xerootg/CAN-CCD_bus/board/eelib-master/README.md

# EELib #
A library of components for the KiCad EDA tool.

Component List:
* MCP2515 - Microchip CAN Controller with SPI interface
* MCP2551 - Microchip CAN Transceiver
* PIC32MX2XXX - Microchip 32 bit microcontroller

Licensed under [CC BY-SA 3.0](http://creativecommons.org/licenses/by-sa/3.0/)
