xerootg/CAN-CCD_bus/(list of files, drawings)

Other design files:
board/ccd_can_bridge.dsn
