xerootg/CAN-CCD_bus/board/ccd_can_bridge.kicad_pcb

## KiCad design board/ccd_can_bridge.kicad_pcb (2018-04-17)

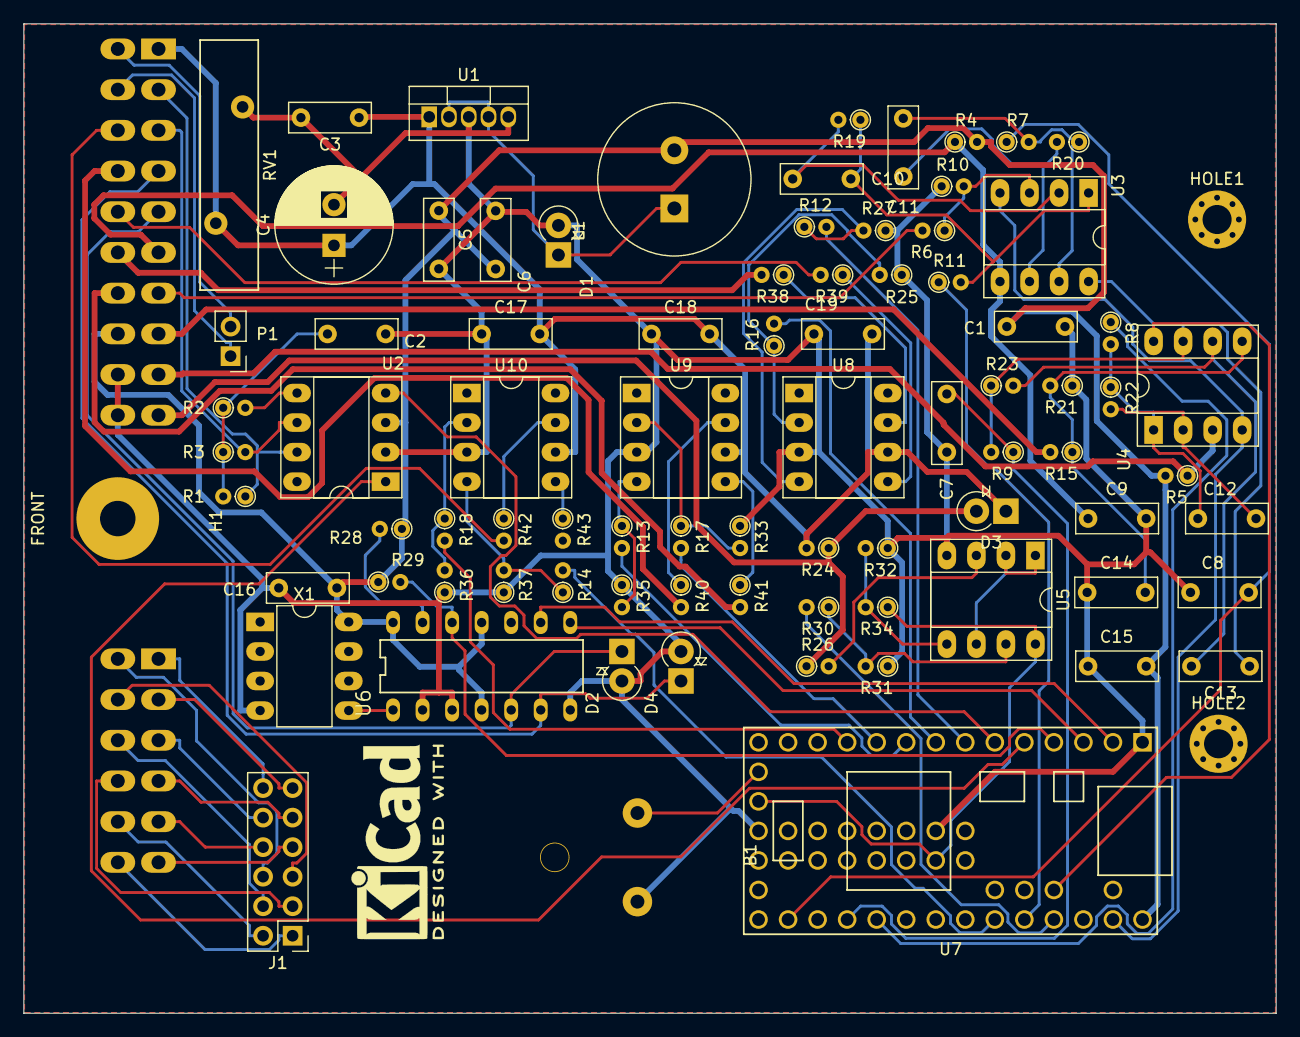
[picture p1: board ccd_can_bridge.kicad_pcb from above]

Board: 2 copper layers, 107.7 x 85.1 mm, 85 parts (0 on the bottom side), 82 nets.

Parts:
B1: 1066; keystone_1067
C1, C3, C6, C17, C18, C19: 0.1uF; C_Disc_D7.0mm_W2.5mm_P5.00mm
C2: 4700pF; C_Disc_D7.0mm_W2.5mm_P5.00mm
C4: 100uF; CP_Radial_D10.0mm_P3.50mm
C5: 100uF; C_Disc_D7.0mm_W2.5mm_P5.00mm
C7, C8, C9, C10, C11, C12, C13, C14: 10uF; C_Disc_D7.0mm_W2.5mm_P5.00mm
C15, C16: C; C_Disc_D7.0mm_W2.5mm_P5.00mm
D1: 1N5819; D_DO-41_SOD81_P2.54mm_Vertical_KathodeUp
D2, D4: 1N4728; D_DO-41_SOD81_P2.54mm_Vertical_KathodeUp
D3: D; D_DO-41_SOD81_P2.54mm_Vertical_KathodeUp
H1: Modice_ME-MX_32; modice_ME-MX-32-position
HOLE1, HOLE2: MountingHole_2.5mm_Pad_Via
J1: CONN_01X12; Pin_Header_Straight_2x06_Pitch2.54mm
L1: 100uH; Inductor_Radial_D13.0mm_P5.00mm
P1: CONN_01X02; Pin_Header_Straight_1x02_Pitch2.54mm
R1, R3: 60; R_Axial_DIN0204_L3.6mm_D1.6mm_P1.90mm_Vertical
R2: 300; R_Axial_DIN0204_L3.6mm_D1.6mm_P1.90mm_Vertical
R4, R5: 130; R_Axial_DIN0204_L3.6mm_D1.6mm_P1.90mm_Vertical
R6, R15: 560; R_Axial_DIN0204_L3.6mm_D1.6mm_P1.90mm_Vertical
R7, R8, R9, R10, R11, R19, R20, R21, R22, R23, R25, R27, R30, R31, R33, R35, R36, R37: 1k; R_Axial_DIN0204_L3.6mm_D1.6mm_P1.90mm_Vertical
R12, R13, R14, R16, R17, R18: 20; R_Axial_DIN0204_L3.6mm_D1.6mm_P1.90mm_Vertical
R24, R26, R28, R29: 10k; R_Axial_DIN0204_L3.6mm_D1.6mm_P1.90mm_Vertical
R32: 37k; R_Axial_DIN0204_L3.6mm_D1.6mm_P1.90mm_Vertical
R34: 15k; R_Axial_DIN0204_L3.6mm_D1.6mm_P1.90mm_Vertical
R38, R39, R40, R41, R42, R43: 100; R_Axial_DIN0204_L3.6mm_D1.6mm_P1.90mm_Vertical
RV1: ERZ-V20D220; RV_Disc_D21.5_W5_P10
U1: LM2576HVS-5.0/NOPB; TO-220-5_Pentawatt_Multiwatt-5_Vertical
U2: MCP2561; DIP-8_W7.62mm_Socket_LongPads
U3, U4, U5: MCP6002; DIP-8_W7.62mm_Socket_LongPads
U6: CDP68HC68S1
U7: Teensy3.2; Teensy30_31_32_LC
U8, U9, U10: TC4427; DIP-8_W7.62mm_Socket_LongPads
X1: OSCILLATOR-VDD-4; DIP-8_W7.62mm_LongPads

Connections:
+3V3: R34.1, U5.8, U7.16, U7.50
+12V: C3.1, C4.1, C17.2, C18.2, C19.2, D3.1, H1.1, R24.2, RV1.1, U1.1, U8.6, U9.6, U10.6
A0_fuel_level: C8.2, R7.1, U7.21
A1_VSS_count: R11.1, U7.29
A2_oil_pressure: C7.2, R9.1, U7.23
A3_steering_wheel: R8.1, U7.24
Earth: B1.-, C1.1, C2.1, C3.2, C4.2, C5.2, C6.2, C7.1, C8.1, C9.1, C14.1, C15.2, C16.2, C17.1, C18.1, C19.1, D1.2, D2.2, D4.2, H1.19, H1.20, R10.1, R21.1, R25.1, R27.1, R31.1, R32.1, R33.1, R35.1, R36.1, R37.1, RV1.2, U1.3, U1.5, U2.2, U5.4, U6.2, U6.3, U6.7, U7.1, U7.17, U7.39, U8.3, U9.3, U10.3, X1.4
unnamed: B1.+, U7.15
unnamed: C2.2, R1.2, R2.1, R3.1
unnamed: C10.1, R11.2, R19.1, U3.1
unnamed: C10.2, R19.2, U3.2
unnamed: C11.1, R7.2, R20.1, U3.7
unnamed: C11.2, R20.2, U3.6
unnamed: C12.1, R8.2, R22.1, U4.1
unnamed: C12.2, R22.2, U4.2
unnamed: C13.1, R9.2, R23.1, U4.7
unnamed: C13.2, R23.2, U4.6
unnamed: C14.2, R15.1, R21.2, U4.5
unnamed: D1.1, L1.1, U1.2, U1.4
unnamed: H1.11, P1.2
unnamed: H1.12, P1.1
unnamed: H1.21, J1.12
unnamed: H1.22, J1.11
unnamed: H1.23, J1.10
unnamed: H1.24, J1.9
unnamed: H1.25, J1.8
unnamed: H1.26, J1.7
unnamed: H1.27, J1.6
unnamed: H1.28, J1.5
unnamed: H1.29, J1.4
unnamed: H1.30, J1.3
unnamed: H1.31, J1.2
unnamed: H1.32, J1.1
unnamed: R2.2, U2.5
unnamed: R6.1, R10.2, U3.3
unnamed: R12.1, R27.2, U8.4
unnamed: R13.1, R35.2, U9.4
unnamed: R14.1, R37.2, U10.4
unnamed: R16.1, R25.2, U8.2
unnamed: R17.1, R33.2, U9.2
unnamed: R18.1, R36.2, U10.2
unnamed: R26.2, U5.3
unnamed: R28.2, U6.13
unnamed: R30.1, R31.2, U5.7
unnamed: R32.2, R34.2, U5.5
unnamed: R38.1, U8.7
unnamed: R39.1, U8.5
unnamed: R40.1, U9.7
unnamed: R41.1, U9.5
unnamed: R42.1, U10.7
unnamed: R43.1, U10.5
unnamed: U5.1, U5.2, U5.6
unnamed: U6.1, X1.5
agnd: U3.4, U4.4, U7.32
alt_sig: R30.2, U7.30
alternator_lamp_in: D3.2, H1.10, R24.1, R26.1
aref: U3.8, U4.8, U7.35
can_rx: U2.4, U7.6
can_tx: U2.1, U7.5
canh_in: H1.2, R1.1, U2.7
canl_in: H1.3, R3.2, U2.6
ccd+: D2.1, H1.5, U6.5
ccd-: D4.1, H1.4, U6.6
cruise_en: R13.2, U7.9
cruise_enable_out: H1.17, R41.2
cruise_res: R16.2, U7.8
cruise_res_out: H1.16, R38.2
cruise_set: R12.2, U7.7
cruise_set_out: H1.15, R39.2
fuel_level_in: C9.2, H1.6, R4.1, U3.5
glowplug_lamp_out: H1.14, R40.2
gp_out: R17.2, U7.10
idle: R29.2, U6.12, U7.4
misc_out_en: R14.2, U7.28
oil_pressure_in: H1.8, R15.2
rxd: U6.9, U7.2
signal_5v_out: C1.2, C5.1, C6.1, C15.1, C16.1, H1.18, L1.2, R4.2, R5.2, R28.1, R29.1, U2.3, U6.4, U6.11, U6.14, U7.33, X1.8
steering_wheel_in: H1.9, R5.1, U4.3
txd: U6.8, U7.3
vss_in: H1.7, R6.2
vss_out: H1.13, R42.2
vss_pwm: R18.2, U7.11
