xerootg/CAN-CCD_bus/(commit log)

2016-06-26 Custom scaling for coolant temperature. Might have to make vehicle definitions later if they end up being different per vehicle platform.
2018-04-17 adding PCB and schematic
    [ccd_can_bridge.dsn, ccd_can_bridge.kicad_pcb, ccd_can_bridge.sch]
2018-04-17 bad pin definition, vss in is on pin 22 and misc out is on pin 21
2018-04-20 modifying tests to run on Teensy as well as native
2018-04-22 Adding a BOM to the readme
